MattisLind/HP21xxReceiverDriver/jlcpcb/production_files/BOM-HP21xxReceiverDriver.csv

Comment | Designator | Footprint | LCSC | Quantity
1N4148WT | D10,D11,D12,D13,D14,D15,D16,D17,D18,D2,D8,D9 | D_SOD-523 | C727112 | 12
1k | R17,R20,R23,R26,R29,R32,R35,R38,R4,R41,R44,R47 | R_0402_1005Metric | C11702 | 12
22 | R1,R11,R13,R15,R7,R9 | R_0805_2012Metric | C17561 | 6
220 | R10,R12,R14,R18,R2,R21,R24,R27,R3,R30,R33,R36,R39,R42,R45,R48,R6,R8 | R_0402_1005Metric | C25091 | 18
2k | R16,R19,R22,R25,R28,R31,R34,R37,R40,R43,R46,R49,R5,R50,R51,R52,R53,R54 | R_0402_1005Metric | C4109 | 18
4.7u | C1,C2,C3,C4,C5,C6 | C_0402_1005Metric | C23733 | 6
74ACT04 | U1 | SOIC-14_3.9x8.7mm_P1.27mm | C5490 | 1
AMS1117-3.3 | U2,U4 | SOT-223-3_TabPin2 | C18164485 | 2
BAT54J | D1,D3,D4,D5,D6,D7 | D_SOD-523 | C51315114 | 6
MMBT2369A | Q1,Q10,Q11,Q12,Q13,Q14,Q15,Q16,Q17,Q18,Q2,Q3,Q4,Q5,Q6,Q7,Q8,Q9 | SOT-23 | C94404 | 18
DIP24 | J2 | DIP-24_18.0mmx34.29mm_W15.24mm |  | 1
DIP24 | J1 | DIP-24_18.0mmx34.29mm_W15.24mm |  | 1
DIP24 | J3 | DIP-24_18.0mmx34.29mm_W15.24mm |  | 1
