MattisLind/HP21xxReceiverDriver/HP21xxReceiverDriver.pdf

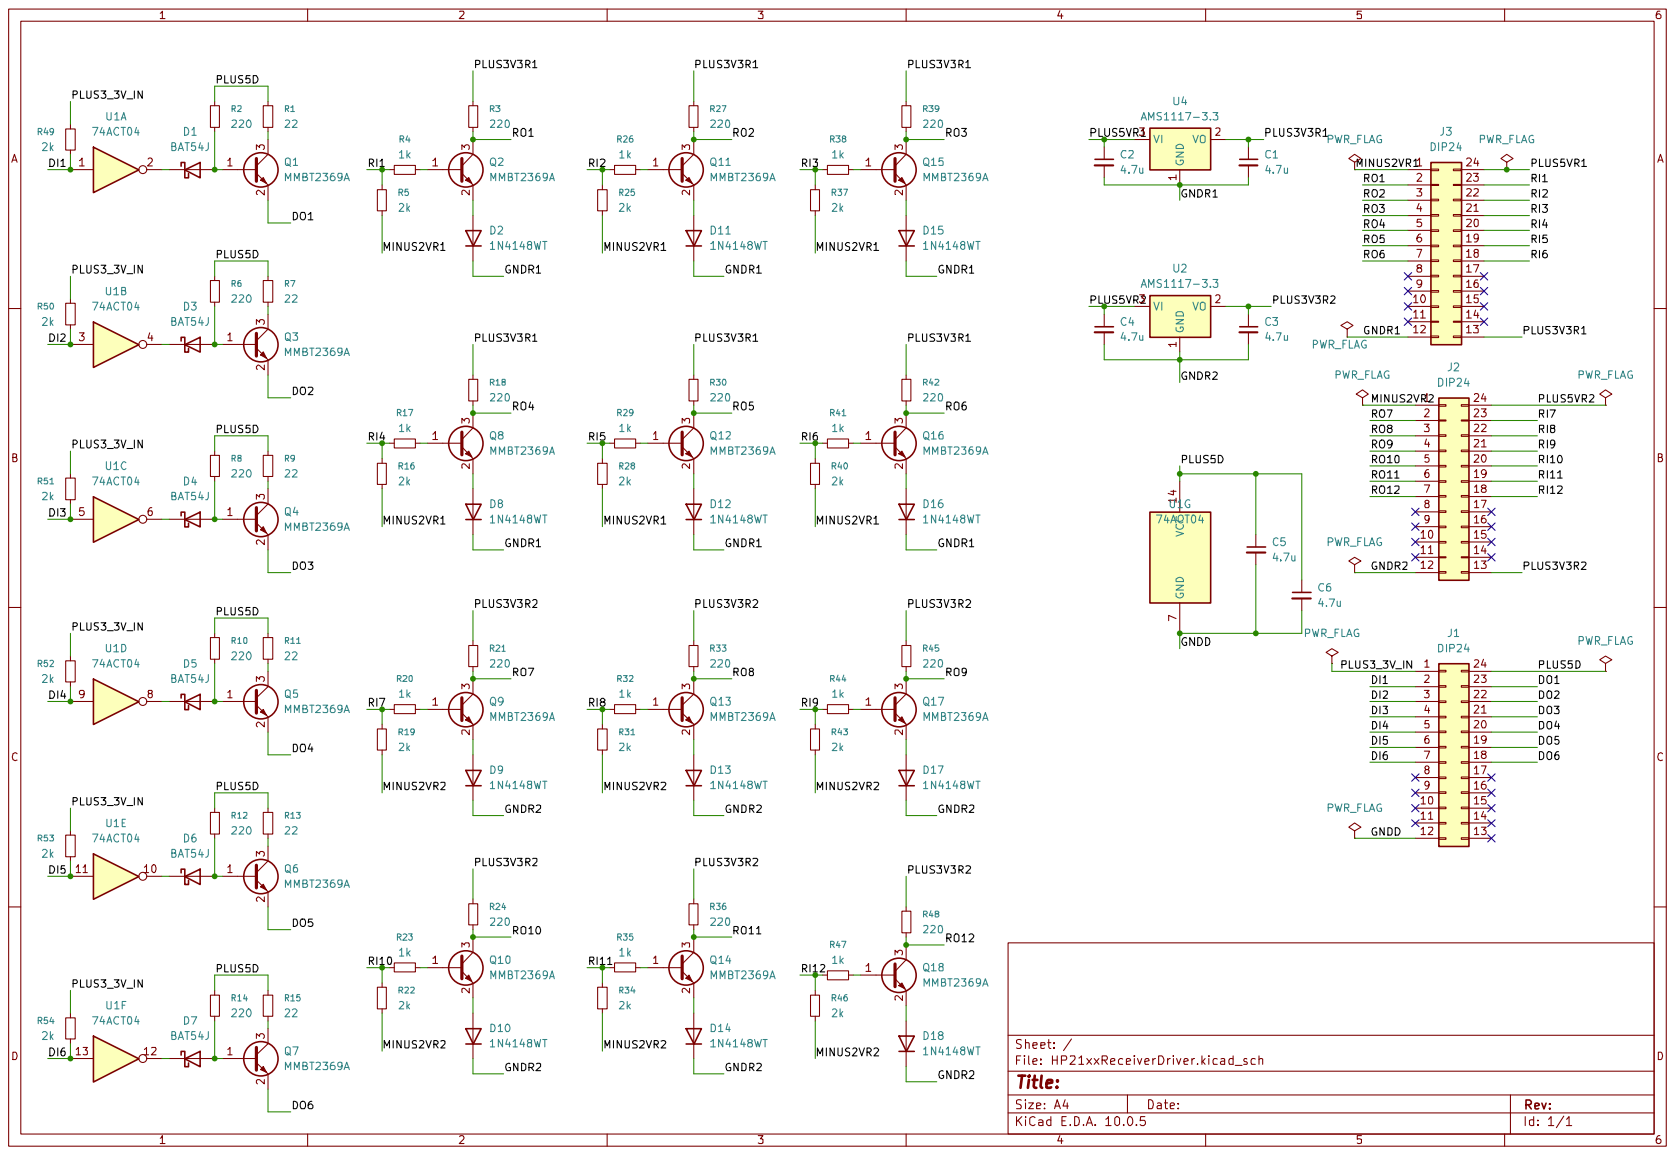
[picture p2: page 1]
