MattisLind/HP21xxReceiverDriver/HP21xxReceiverDriver.kicad_pcb

## KiCad design HP21xxReceiverDriver.kicad_pcb (2026-10-23)

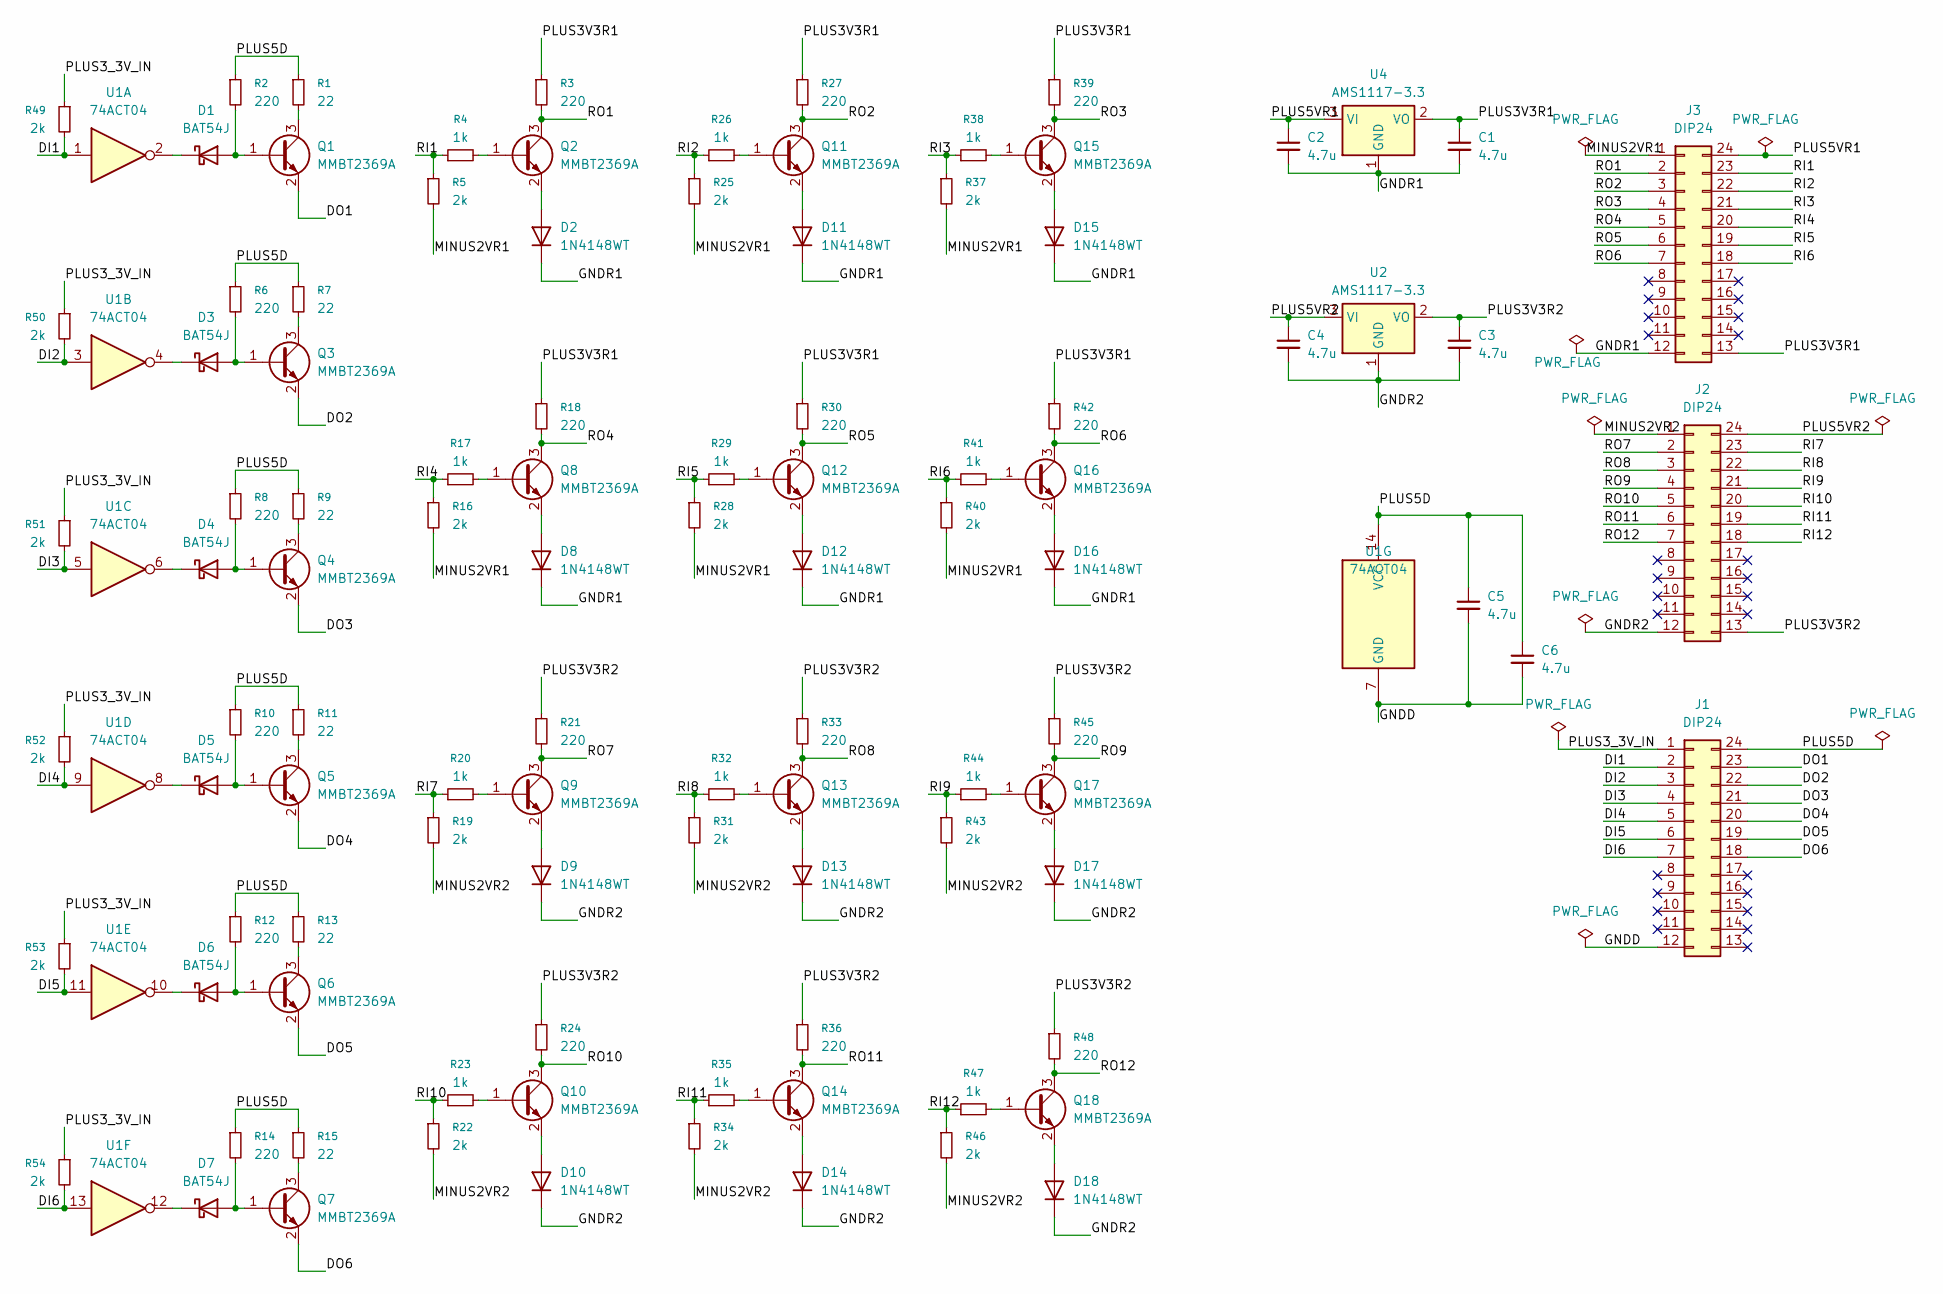
[picture p3: schematic HP21xxReceiverDriver.kicad_sch]

Parts:
C1, C2, C3, C4, C5, C6: 4.7u; C_0402_1005Metric; LCSC C23733
D1, D3, D4, D5, D6, D7: BAT54J; D_SOD-523; LCSC C51315114
D2, D8, D9, D10, D11, D12, D13, D14, D15, D16, D17, D18: 1N4148WT; D_SOD-523; LCSC C727112
J1, J2, J3: DIP24; DIP-24_18.0mmx34.29mm_W15.24mm
Q1, Q2, Q3, Q4, Q5, Q6, Q7, Q8, Q9, Q10, Q11, Q12, Q13, Q14, Q15, Q16, Q17, Q18: MMBT2369A; SOT-23; LCSC C94404
R1, R7, R9, R11, R13, R15: 22; R_0805_2012Metric; LCSC C17561
R2, R3, R6, R8, R10, R12, R14, R18, R21, R24, R27, R30, R33, R36, R39, R42, R45, R48: 220; R_0402_1005Metric; LCSC C25091
R4, R17, R20, R23, R26, R29, R32, R35, R38, R41, R44, R47: 1k; R_0402_1005Metric; LCSC C11702
R5, R16, R19, R22, R25, R28, R31, R34, R37, R40, R43, R46, R49, R50, R51, R52, R53, R54: 2k; R_0402_1005Metric; LCSC C4109
U1: 74ACT04; SOIC-14_3.9x8.7mm_P1.27mm; LCSC C5490
U2, U4: AMS1117-3.3; SOT-223-3_TabPin2; LCSC C18164485

Connections:
/DI1: J1.2, R49.2, U1.1
/DI2: J1.3, R50.2, U1.3
/DI3: J1.4, R51.2, U1.5
/DI4: J1.5, R52.2, U1.9
/DI5: J1.6, R53.2, U1.11
/DI6: J1.7, R54.2, U1.13
/DO1: J1.23, Q1.2 (E)
/DO2: J1.22, Q3.2 (E)
/DO3: J1.21, Q4.2 (E)
/DO4: J1.20, Q5.2 (E)
/DO5: J1.19, Q6.2 (E)
/DO6: J1.18, Q7.2 (E)
/GNDD: C5.2, C6.2, J1.12, U1.7 (GND)
/GNDR1: C1.2, C2.2, D2.1 (K), D8.1 (K), D11.1 (K), D12.1 (K), D15.1 (K), D16.1 (K), J3.12, U4.1 (GND)
/GNDR2: C3.2, C4.2, D9.1 (K), D10.1 (K), D13.1 (K), D14.1 (K), D17.1 (K), D18.1 (K), J2.12, U2.1 (GND)
/MINUS2VR1: J3.1, R5.2, R16.2, R25.2, R28.2, R37.2, R40.2
/MINUS2VR2: J2.1, R19.2, R22.2, R31.2, R34.2, R43.2, R46.2
/PLUS3V3R1: C1.1, J3.13, R3.1, R18.1, R27.1, R30.1, R39.1, R42.1, U4.2 (VO)
/PLUS3V3R2: C3.1, J2.13, R21.1, R24.1, R33.1, R36.1, R45.1, R48.1, U2.2 (VO)
/PLUS3_3V_IN: J1.1, R49.1, R50.1, R51.1, R52.1, R53.1, R54.1
/PLUS5D: C5.1, C6.1, J1.24, R1.1, R2.1, R6.1, R7.1, R8.1, R9.1, R10.1, R11.1, R12.1, R13.1, R14.1, R15.1, U1.14 (VCC)
/PLUS5VR1: C2.1, J3.24, U4.3 (VI)
/PLUS5VR2: C4.1, J2.24, U2.3 (VI)
/RI1: J3.23, R4.1, R5.1
/RI2: J3.22, R25.1, R26.1
/RI3: J3.21, R37.1, R38.1
/RI4: J3.20, R16.1, R17.1
/RI5: J3.19, R28.1, R29.1
/RI6: J3.18, R40.1, R41.1
/RI7: J2.23, R19.1, R20.1
/RI8: J2.22, R31.1, R32.1
/RI9: J2.21, R43.1, R44.1
/RI10: J2.20, R22.1, R23.1
/RI11: J2.19, R34.1, R35.1
/RI12: J2.18, R46.1, R47.1
/RO1: J3.2, Q2.3 (C), R3.2
/RO2: J3.3, Q11.3 (C), R27.2
/RO3: J3.4, Q15.3 (C), R39.2
/RO4: J3.5, Q8.3 (C), R18.2
/RO5: J3.6, Q12.3 (C), R30.2
/RO6: J3.7, Q16.3 (C), R42.2
/RO7: J2.2, Q9.3 (C), R21.2
/RO8: J2.3, Q13.3 (C), R33.2
/RO9: J2.4, Q17.3 (C), R45.2
/RO10: J2.5, Q10.3 (C), R24.2
/RO11: J2.6, Q14.3 (C), R36.2
/RO12: J2.7, Q18.3 (C), R48.2
unnamed: D1.2 (A), Q1.1 (B), R2.2
unnamed: D1.1 (K), U1.2
unnamed: D2.2 (A), Q2.2 (E)
unnamed: D3.2 (A), Q3.1 (B), R6.2
unnamed: D3.1 (K), U1.4
unnamed: D4.2 (A), Q4.1 (B), R8.2
unnamed: D4.1 (K), U1.6
unnamed: D5.2 (A), Q5.1 (B), R10.2
unnamed: D5.1 (K), U1.8
unnamed: D6.2 (A), Q6.1 (B), R12.2
unnamed: D6.1 (K), U1.10
unnamed: D7.2 (A), Q7.1 (B), R14.2
unnamed: D7.1 (K), U1.12
unnamed: D8.2 (A), Q8.2 (E)
unnamed: D9.2 (A), Q9.2 (E)
unnamed: D10.2 (A), Q10.2 (E)
unnamed: D11.2 (A), Q11.2 (E)
unnamed: D12.2 (A), Q12.2 (E)
unnamed: D13.2 (A), Q13.2 (E)
unnamed: D14.2 (A), Q14.2 (E)
unnamed: D15.2 (A), Q15.2 (E)
unnamed: D16.2 (A), Q16.2 (E)
unnamed: D17.2 (A), Q17.2 (E)
unnamed: D18.2 (A), Q18.2 (E)
unnamed: Q1.3 (C), R1.2
unnamed: Q2.1 (B), R4.2
unnamed: Q3.3 (C), R7.2
unnamed: Q4.3 (C), R9.2
unnamed: Q5.3 (C), R11.2
unnamed: Q6.3 (C), R13.2
unnamed: Q7.3 (C), R15.2
unnamed: Q8.1 (B), R17.2
unnamed: Q9.1 (B), R20.2
unnamed: Q10.1 (B), R23.2
unnamed: Q11.1 (B), R26.2
unnamed: Q12.1 (B), R29.2
unnamed: Q13.1 (B), R32.2
unnamed: Q14.1 (B), R35.2
unnamed: Q15.1 (B), R38.2
unnamed: Q16.1 (B), R41.2
unnamed: Q17.1 (B), R44.2
unnamed: Q18.1 (B), R47.2

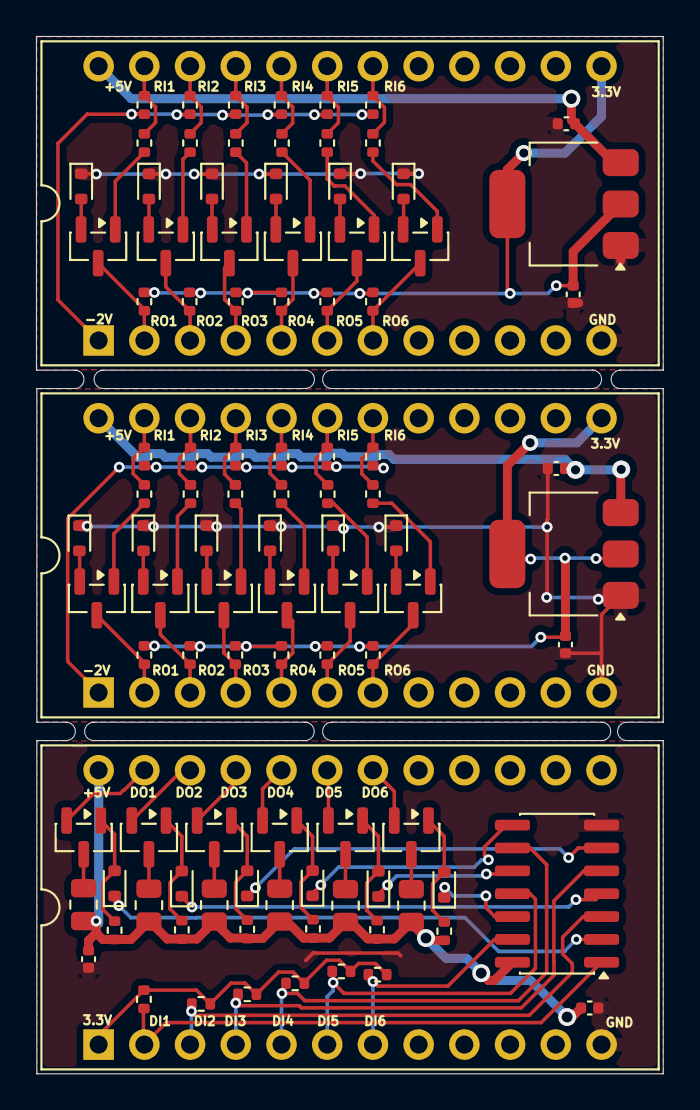
[picture p4: board HP21xxReceiverDriver.kicad_pcb from above]

Board: 2 copper layers, 34.8 x 57.6 mm, 102 parts (0 on the bottom side), 89 nets.
