MattisLind/HP21xxReceiverDriver/(commit log)

2026-03-18 Added a PDF for the schematic.
2026-03-18 Add README content for HP 21xx IO bus project
    Added project description for HP 21xx IO bus driver and receiver.
2026-03-21 Changed to 2k terminating resistors.
    [BOM-HP21xxReceiverDriver.csv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]
2026-10-23 Updated schematics and pcb for 3.3V pullups on the driver inputs.
    [HP21xxReceiverDriver.kicad_pcb, HP21xxReceiverDriver.kicad_sch]
2026-10-23 Fixed fabrication files as well.
    [CPL-HP21xxReceiverDriver.csv, HP21xxReceiverDriver-CuBottom.gbr, HP21xxReceiverDriver-CuTop.gbr, HP21xxReceiverDriver-EdgeCuts.gbr, HP21xxReceiverDriver-MaskBottom.gbr, HP21xxReceiverDriver-MaskTop.gbr, HP21xxReceiverDriver-NPTH.drl, HP21xxReceiverDriver-PTH.drl]
2026-10-23 Updated schematics as well.
